leandro1993/ST-L6470-Motor-Driver/README.md

# ST-L6470-Motor-Driver
Single Motor stepper driver module using ST L6470
