leandro1993/ST-L6470-Motor-Driver/schematic/L6470 Module.pdf

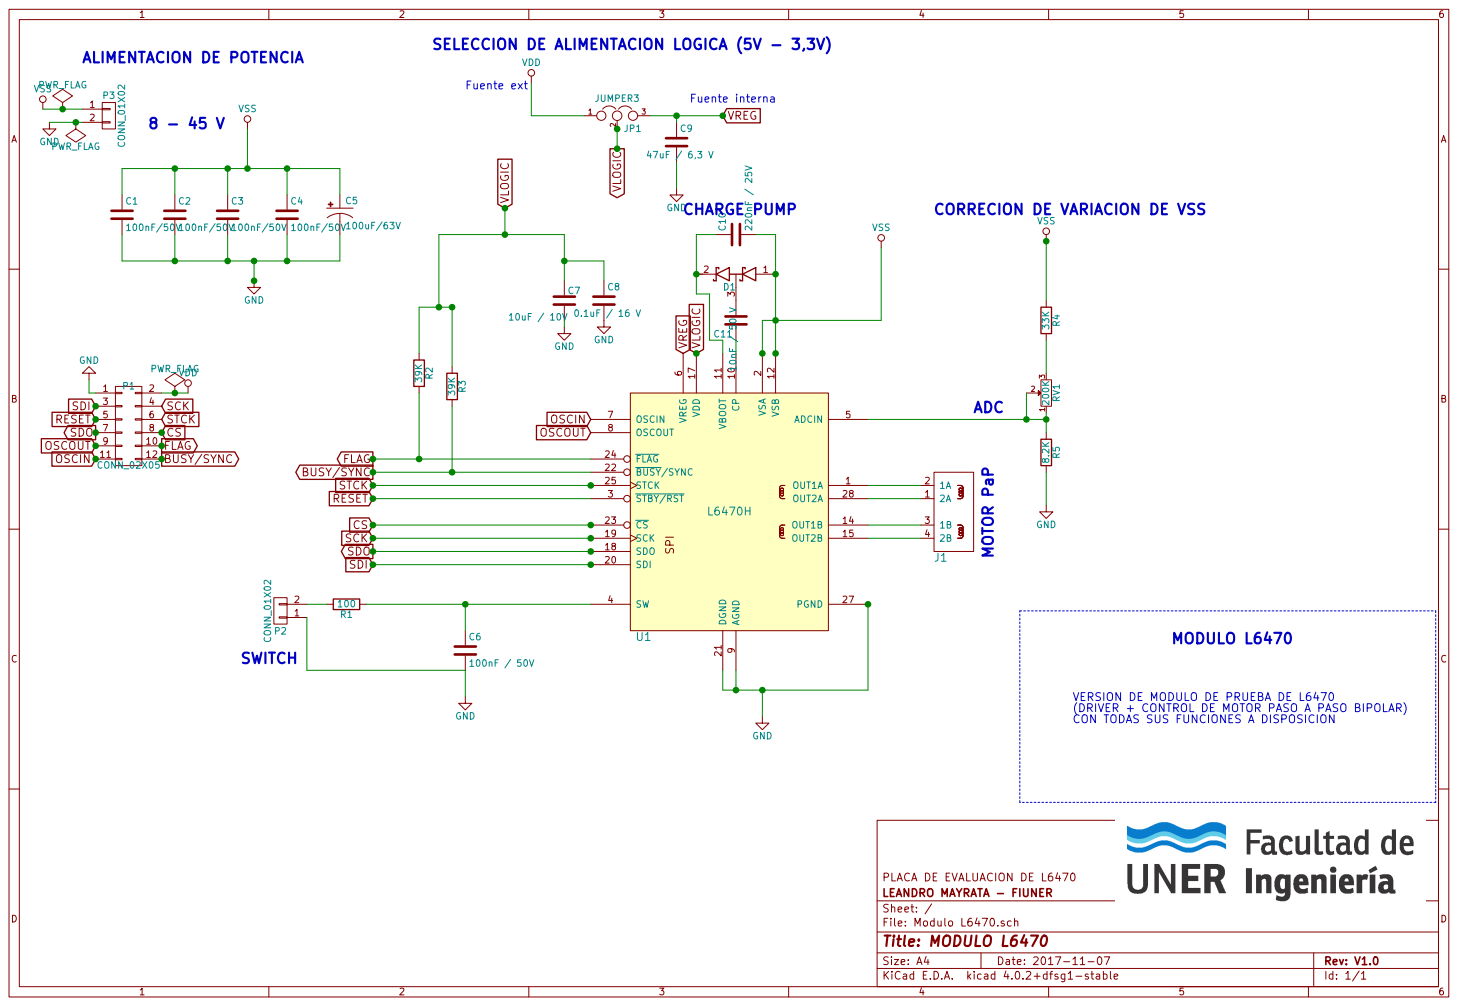
[picture p1: page 1]

SELECCION DE ALIMENTACION LOGICA (5V - 3,3V)
VREG

9 CP 10 SDI 20 VBOOT 11 DGND 21 VSB 12 BUSY/SYNC 22 CS 23 OUT1B 14 FLAG 24 OUT2B 15 STCK 25 VDD 17 PGND 27 SDO 18 OUT2A 28 SCK 19 U1

2 STBY/RST 3 SW 4 ADCIN 5 VREG

VERSION DE MODULO DE PRUEBA DE L6470
(DRIVER + CONTROL DE MOTOR PASO A PASO BIPOLAR)
CON TODAS SUS FUNCIONES A DISPOSICION

File: Modulo L6470.sch Sheet: / LEANDRO MAYRATA - FIUNER
