leandro1993/ST-L6470-Motor-Driver/PCBfiles/ModuloL6470.pdf

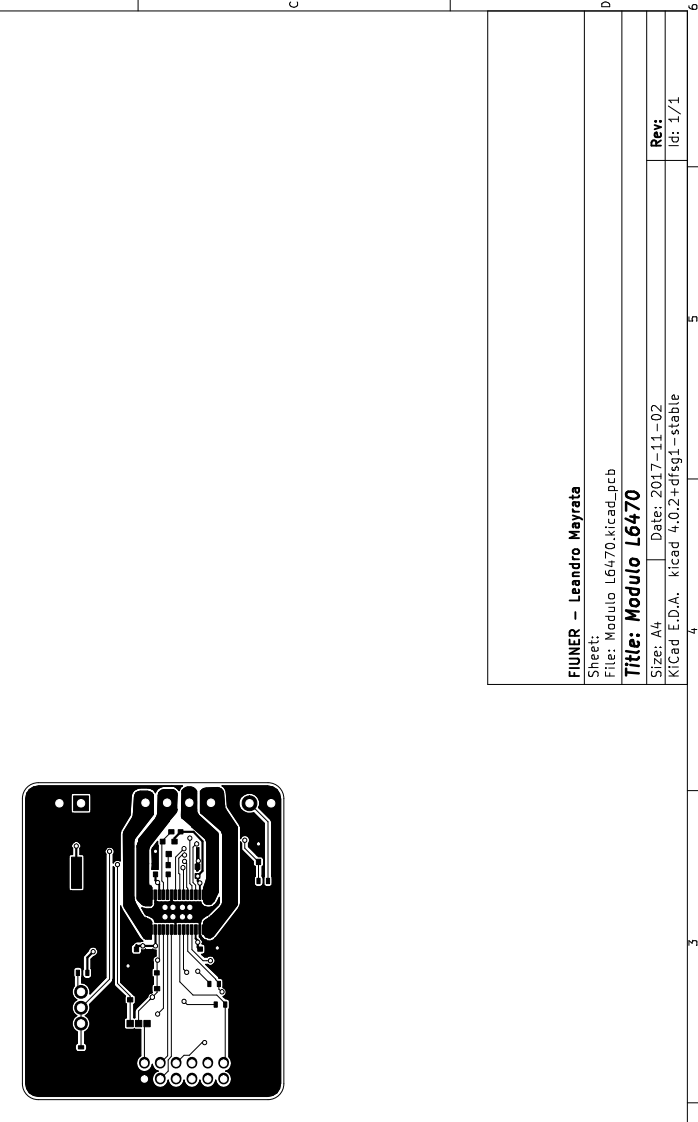
[picture p2: page 1]

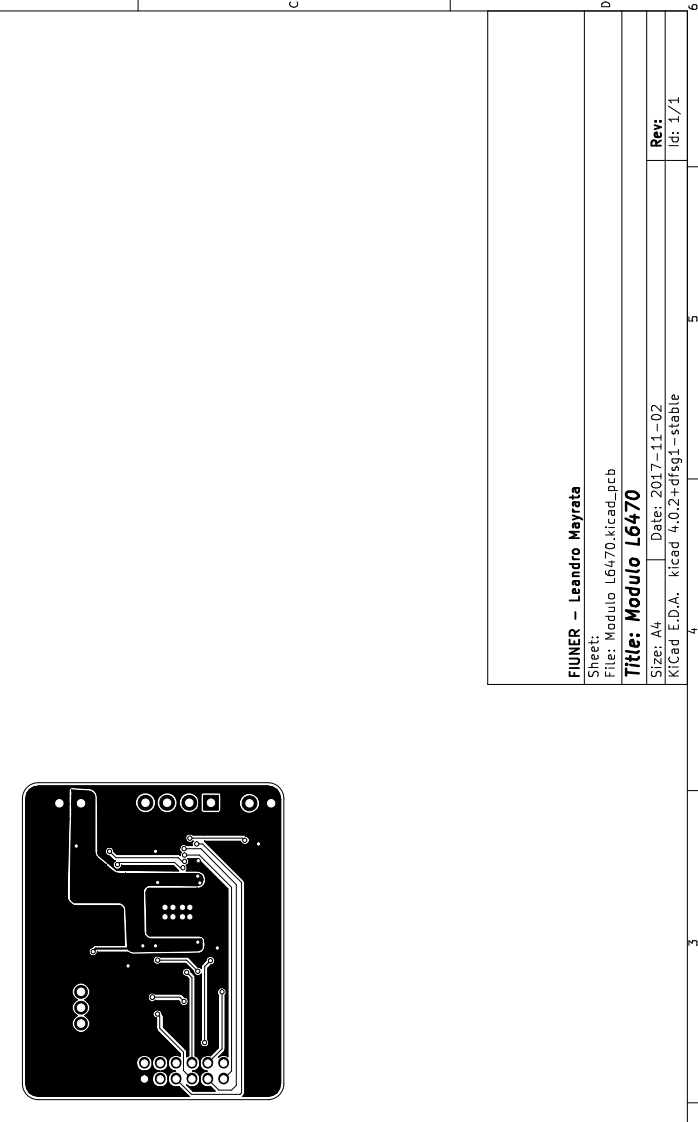
[picture p3: page 2]

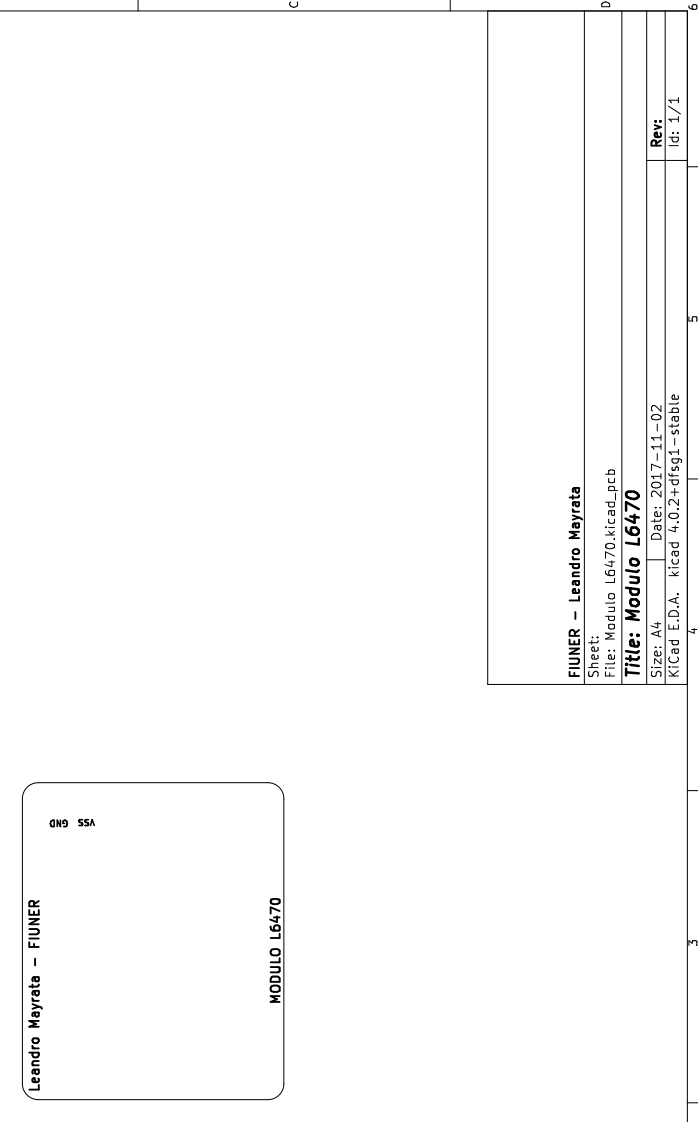
[picture p4: page 3]
