leandro1993/ST-L6470-Motor-Driver/(list of files, drawings)

Other design files:
PCBfiles/Modulo L6470.dsn
