leandro1993/ST-L6470-Motor-Driver/PCBfiles/Modulo L6470.kicad_pcb

## KiCad design PCBfiles/Modulo L6470.kicad_pcb (2018-10-18)

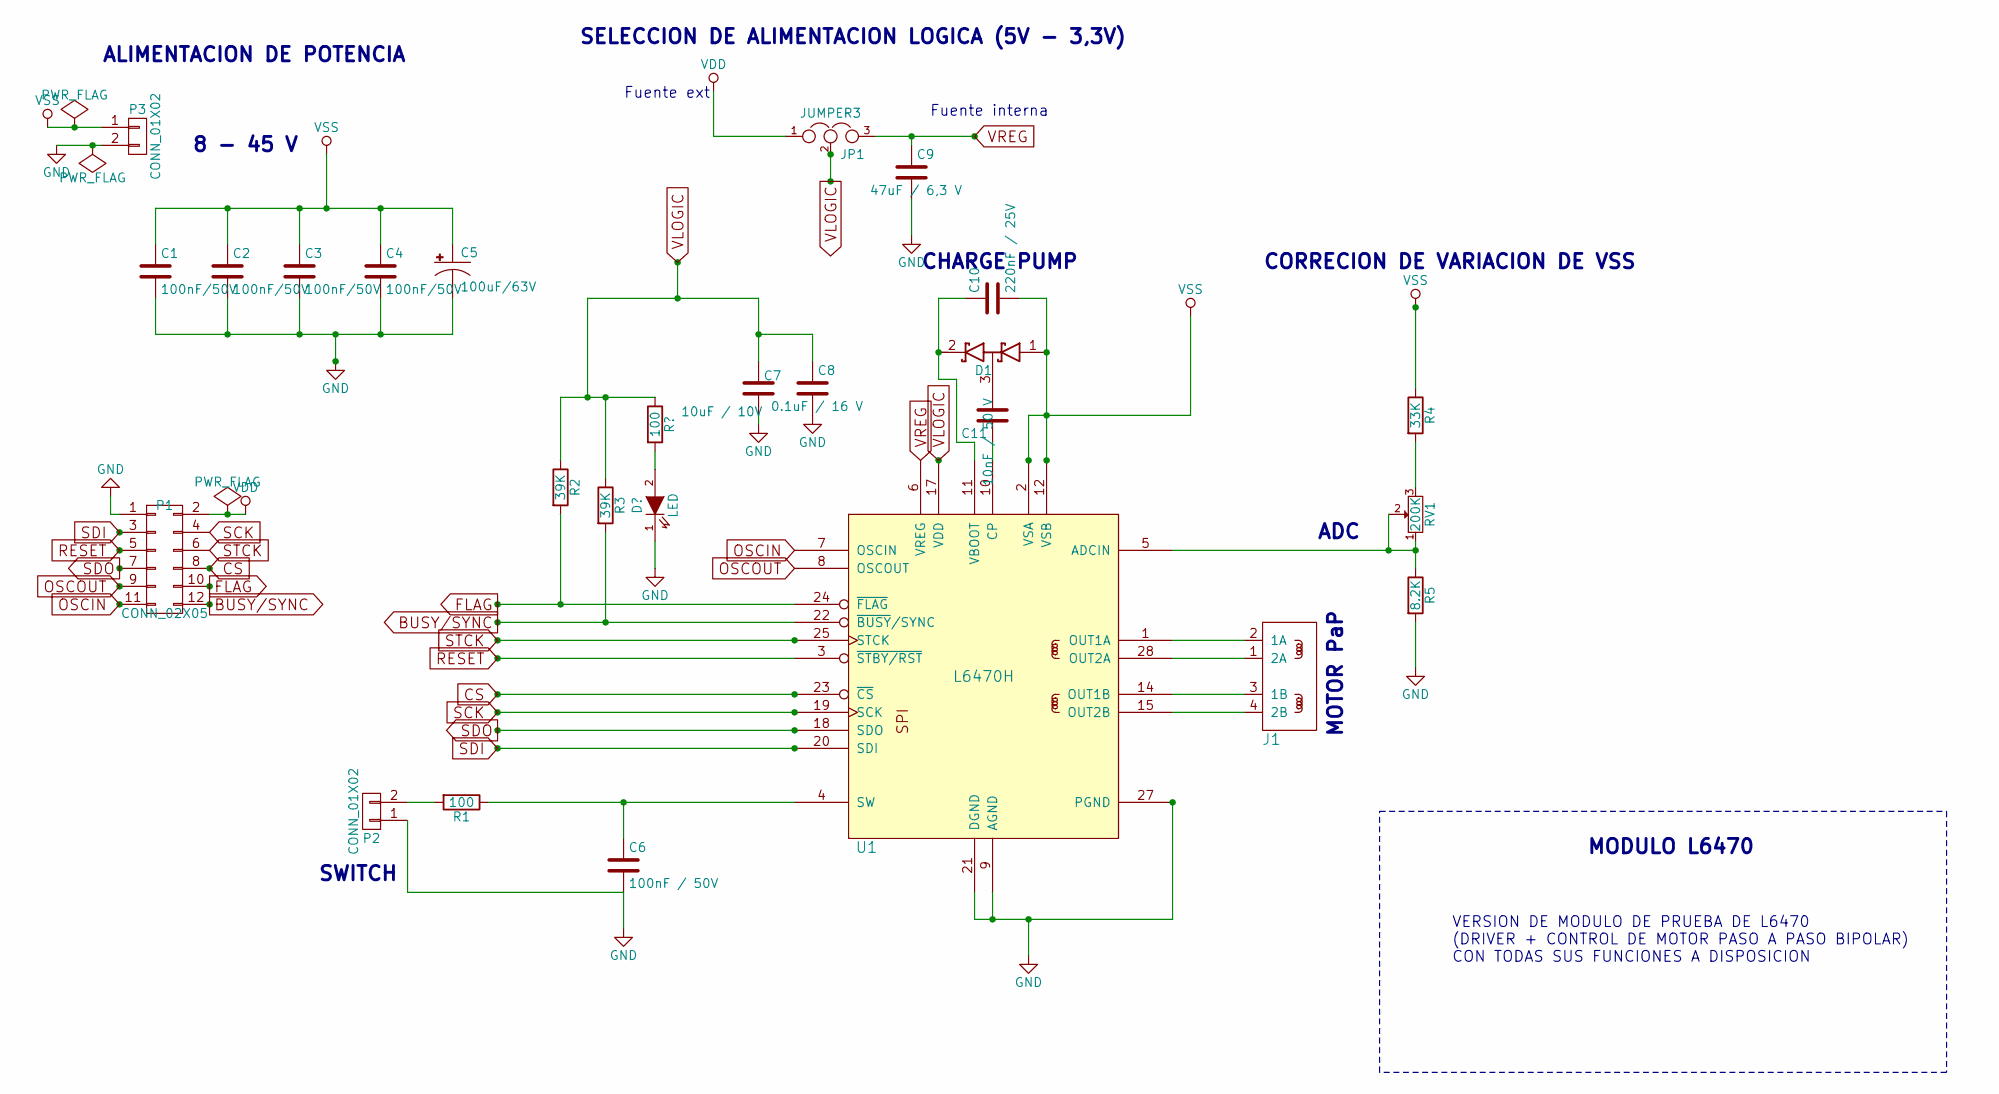
[picture p5: schematic Modulo L6470.sch]

Parts:
C1, C2, C3, C4: 100nF/50V; C_0603
C5: 100uF/63V; PANASONIC_H13
C6: 100nF / 50V; C_0603
C7: 10uF / 10V; C_1206
C8: 0.1uF / 16 V; C_0603
C9: 47uF / 6,3 V; C_0805
C10: 220nF / 25V; C_0603
C11: 10nF / 50 V; C_0603
D1: D_Schottky_x2_Serial_CAK; SOT-23
J1: CONN_STEPPER; TerminalBlock_Pheonix_MKDS1.5-4pol
JP1: JUMPER3; Pin_Header_Straight_1x03
P1: CONN_02X05; Pin_Header_Straight_2x06
P2, P3: CONN_01X02; TerminalBlock_Pheonix_MKDS1.5-2pol
R1: 100; R_0603
R2, R3: 39K; R_0603
R4: 33K; R_0603
R5: 8.2K; R_0603
RV1: 200K; Potentiometer_WirePads_Small
U1: L6470H; tssop-28-pwp

Connections:
BUSY/SYNC: P1.12, R3.2, U1.22 (~BUSY~/SYNC)
CS: P1.8, U1.23 (~CS)
FLAG: P1.10, R2.2, U1.24 (~FLAG)
GND: C1.2, C2.2, C3.2, C4.2, C5.-, C6.2, C7.2, C8.2, C9.2, P1.1, P2.1, P3.2, R5.2, U1.9 (AGND), U1.13 (PGND), U1.21 (DGND), U1.27 (PGND), U1.PAD (PGND)
unnamed: C6.1, R1.1, U1.4 (SW)
unnamed: C10.1, D1.2 (K), U1.11 (VBOOT)
unnamed: C11.1, U1.10 (CP)
unnamed: C11.2, D1.3 (common)
unnamed: J1.1 (2A), U1.28 (OUT2A)
unnamed: J1.2 (1A), U1.1 (OUT1A)
unnamed: J1.3 (1B), U1.14 (OUT1B)
unnamed: J1.4 (2B), U1.15 (OUT2B)
unnamed: P2.2, R1.2
unnamed: R4.2, RV1.3
unnamed: R5.1, RV1.1, RV1.2, U1.5 (ADCIN)
OSCIN: P1.11, U1.7 (OSCIN)
OSCOUT: P1.9, U1.8 (OSCOUT)
RESET: P1.5, U1.3 (~STBY/RST)
SCK: P1.4, U1.19 (SCK)
SDI: P1.3, U1.20 (SDI)
SDO: P1.7, U1.18 (SDO)
STCK: P1.6, U1.25 (STCK)
VDD: JP1.1, P1.2
VLOGIC: C7.1, C8.1, JP1.2, R2.1, R3.1, U1.17 (VDD)
VREG: C9.1, JP1.3, U1.6 (VREG)
VSA: C1.1, C2.1, C3.1, C4.1, C5.+, C10.2, D1.1 (A), P3.1, R4.1, U1.2 (VSA), U1.12 (VSB), U1.16 (VSB), U1.26 (VSA)

Notes on the sheet:
VERSION DE MODULO DE PRUEBA DE L6470 (DRIVER + CONTROL DE MOTOR PASO A PASO BIPOLAR) CON TODAS SUS FUNCIONES A DISPOSICION
MODULO L6470
ALIMENTACION DE POTENCIA
8 - 45 V
SELECCION DE ALIMENTACION LOGICA (5V - 3,3V)
SWITCH
CHARGE PUMP
CORRECION DE VARIACION DE VSS
ADC
MOTOR PaP
Fuente ext
Fuente interna

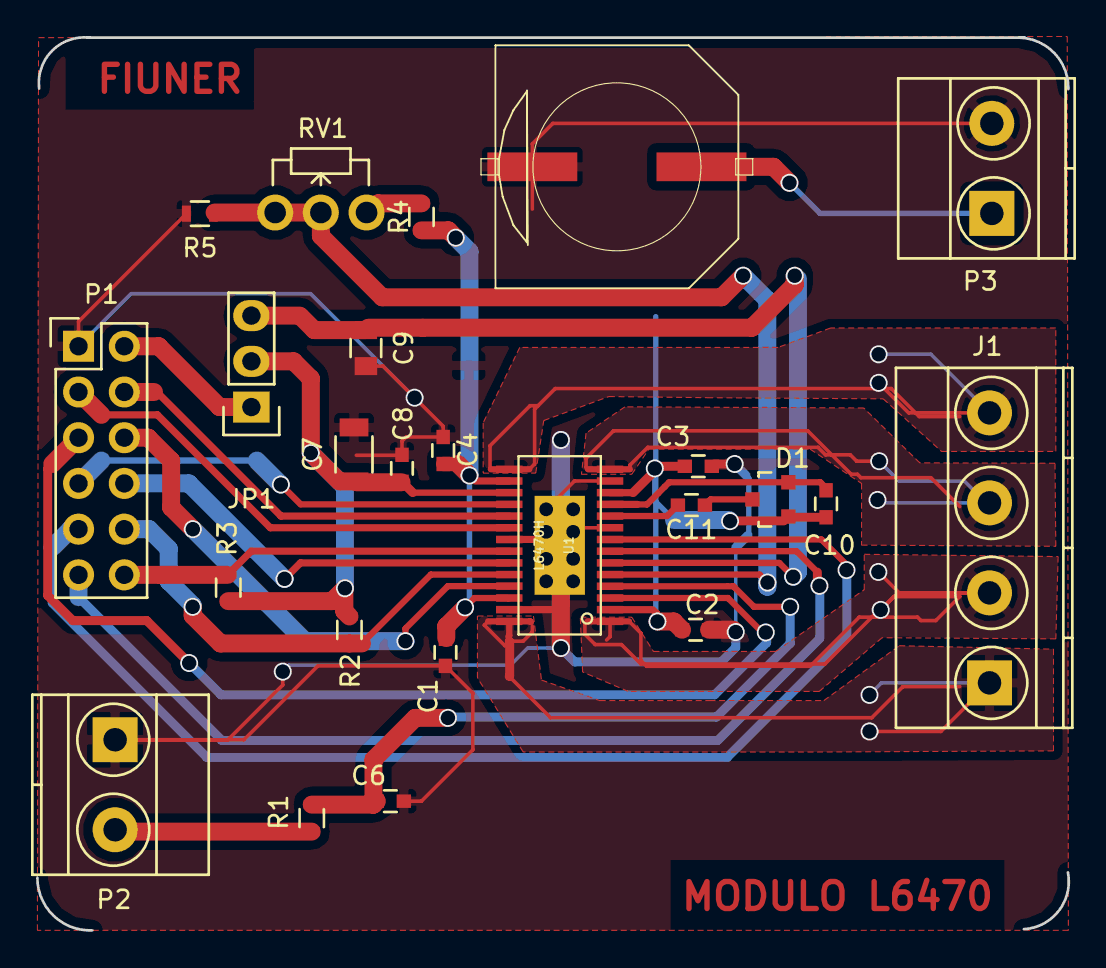
[picture p6: board Modulo L6470.kicad_pcb from above]

Board: 2 copper layers, 57.3 x 49.6 mm, 24 parts (0 on the bottom side), 26 nets.
