leandro1993/ST-L6470-Motor-Driver/(commit log)

2018-10-18 schematic file added
2018-10-18 PCB files added
    [Modulo L6470.csv, Modulo L6470.dsn, Modulo L6470.kicad_pcb, Modulo L6470.sch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]
